saasser/Jukebox-RFID-M5Stack/docs/photos/M5Stack Core SE3.jpeg

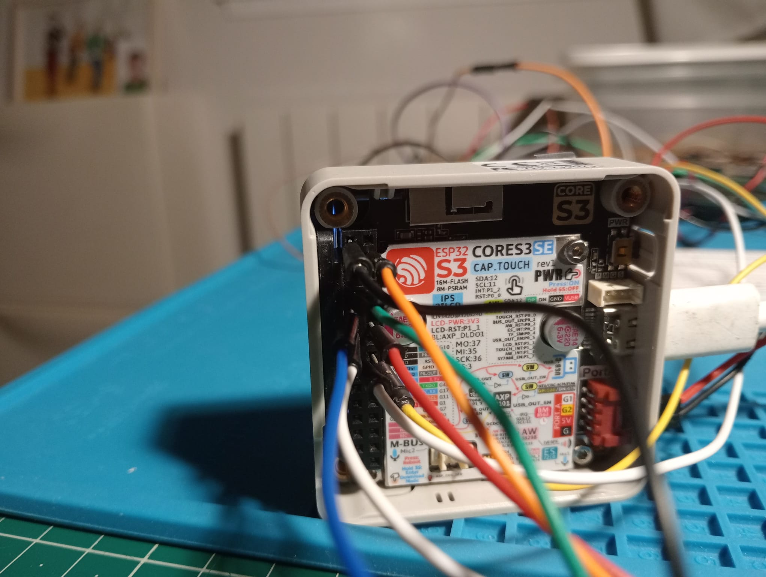
docs/photos/M5Stack Core SE3.jpeg
