saasser/Jukebox-RFID-M5Stack/docs/photos/general_perpectiva.jpeg

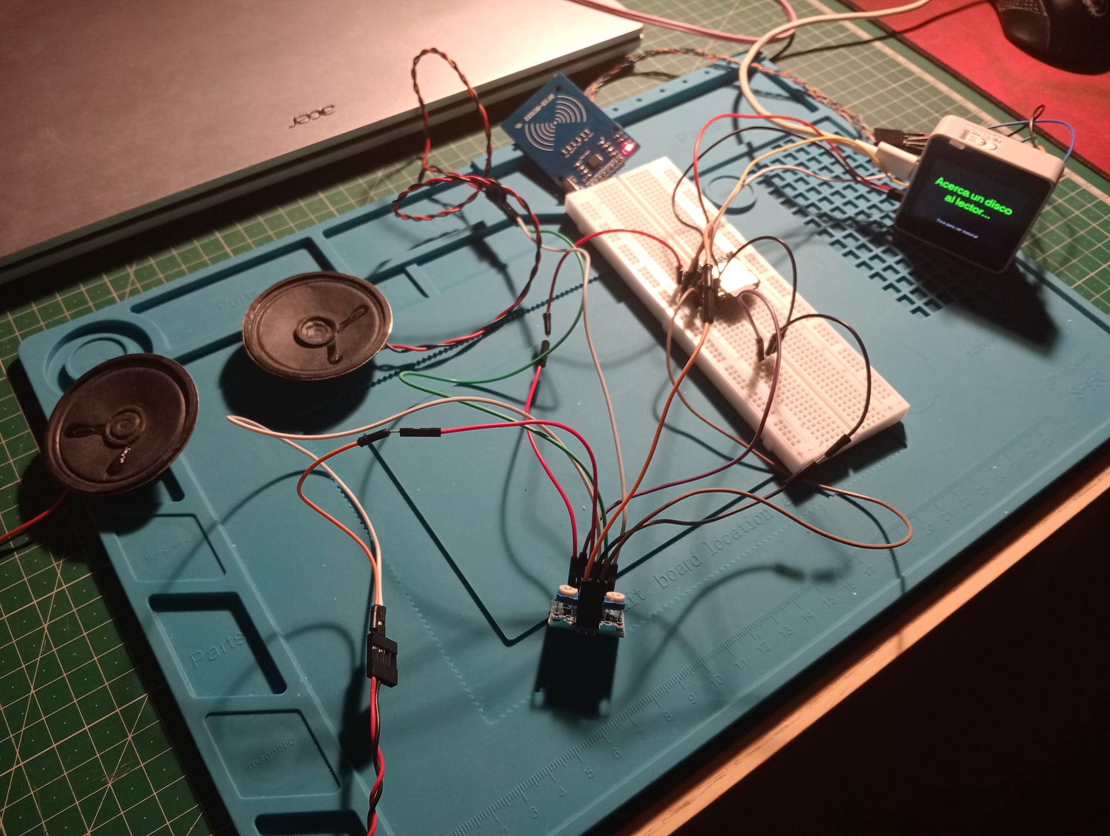
docs/photos/general_perpectiva.jpeg
