saasser/Jukebox-RFID-M5Stack/docs/README.md

# Project Documentation

This directory contains hardware schematics, pinout diagrams, and prototype photos for the RFID Digital Jukebox.
