saasser/Jukebox-RFID-M5Stack/docs/photos/conexionado_DFPlayer_Mini.jpeg

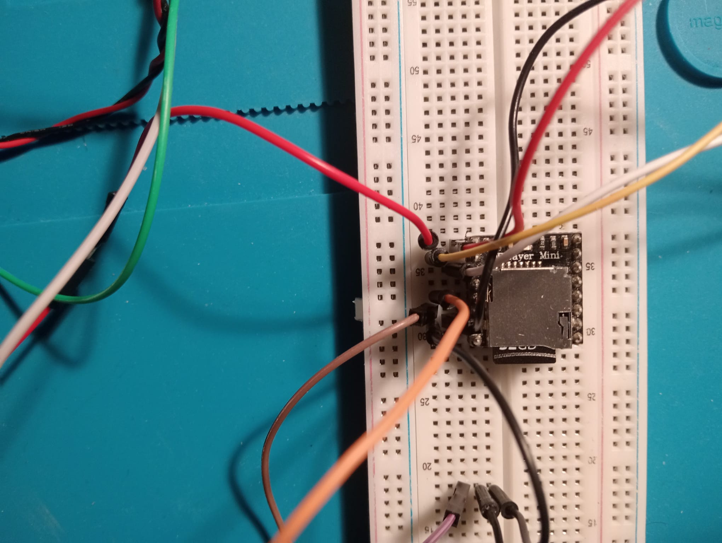
docs/photos/conexionado_DFPlayer_Mini.jpeg
