saasser/Jukebox-RFID-M5Stack/docs/photos/conexionado_PAM8406.jpeg

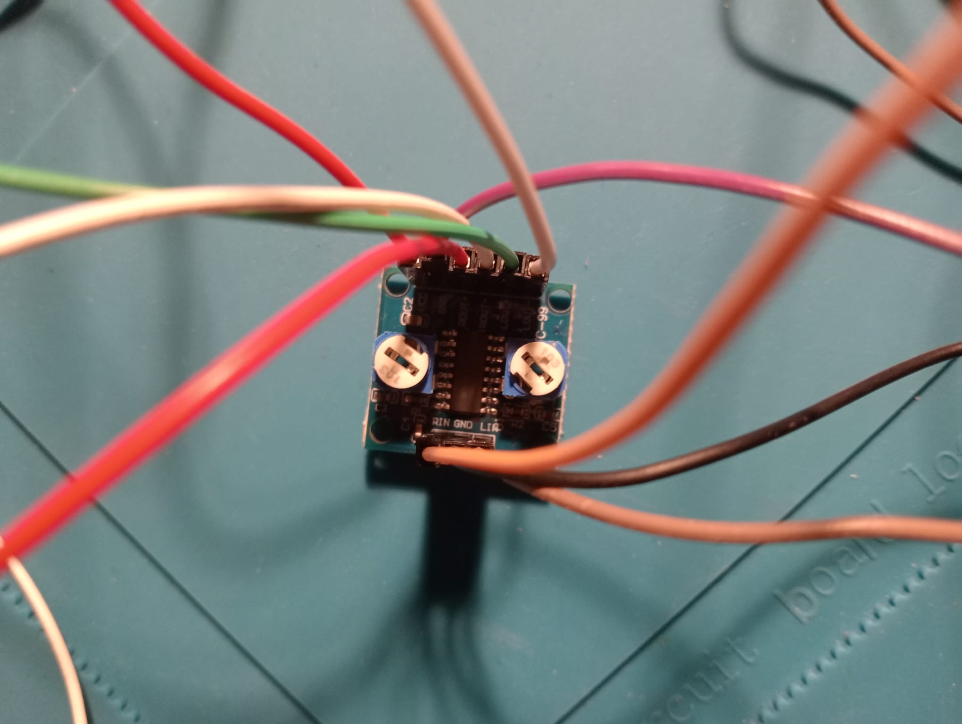
docs/photos/conexionado_PAM8406.jpeg
