saasser/Jukebox-RFID-M5Stack/docs/photos/general_planta.jpeg

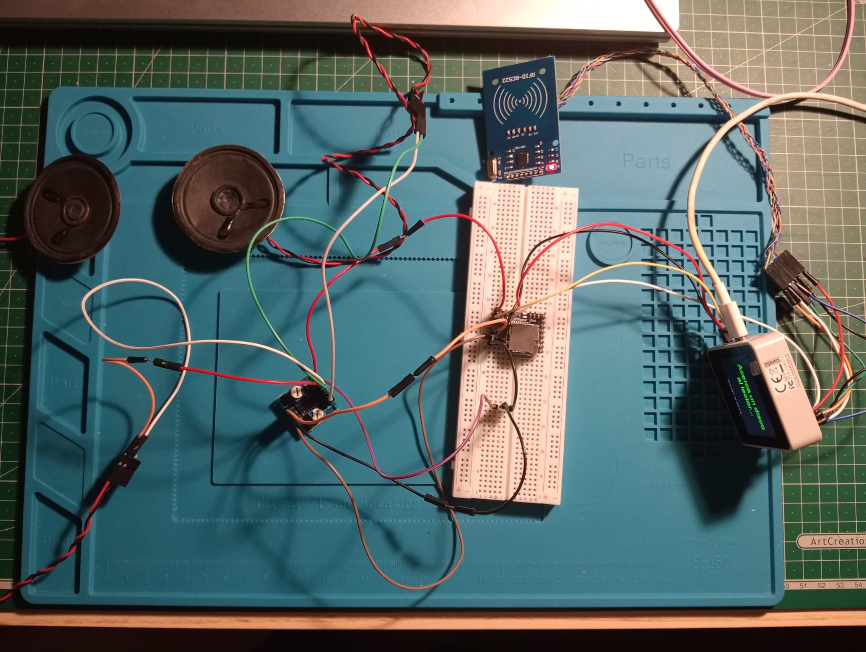
docs/photos/general_planta.jpeg
